amyyu11/autosterilizer/README.md

# autosterilizer
Automatic Ethanol Sterilizer Project repository. Done in collaboration with 5 other people from UCLA BMES.
