amyyu11/autosterilizer/visuals/PCB (FINAL) v3.png

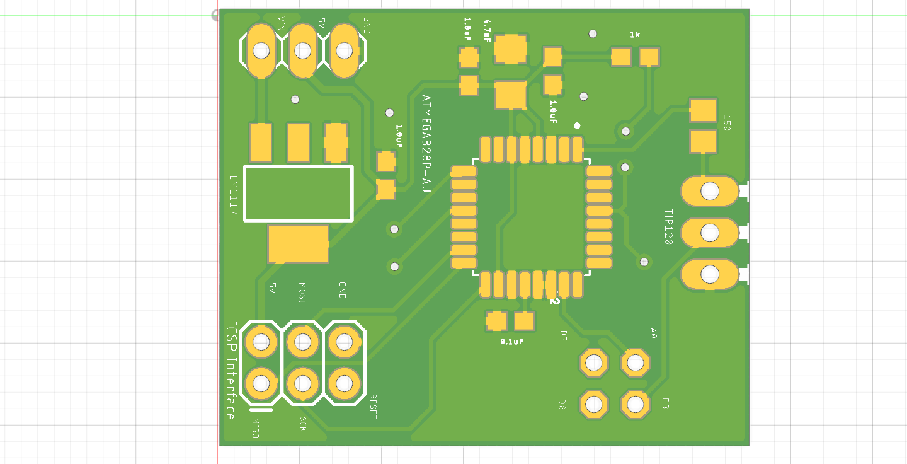
visuals/PCB (FINAL) v3.png
