amyyu11/autosterilizer/visuals/PCB cad object.png

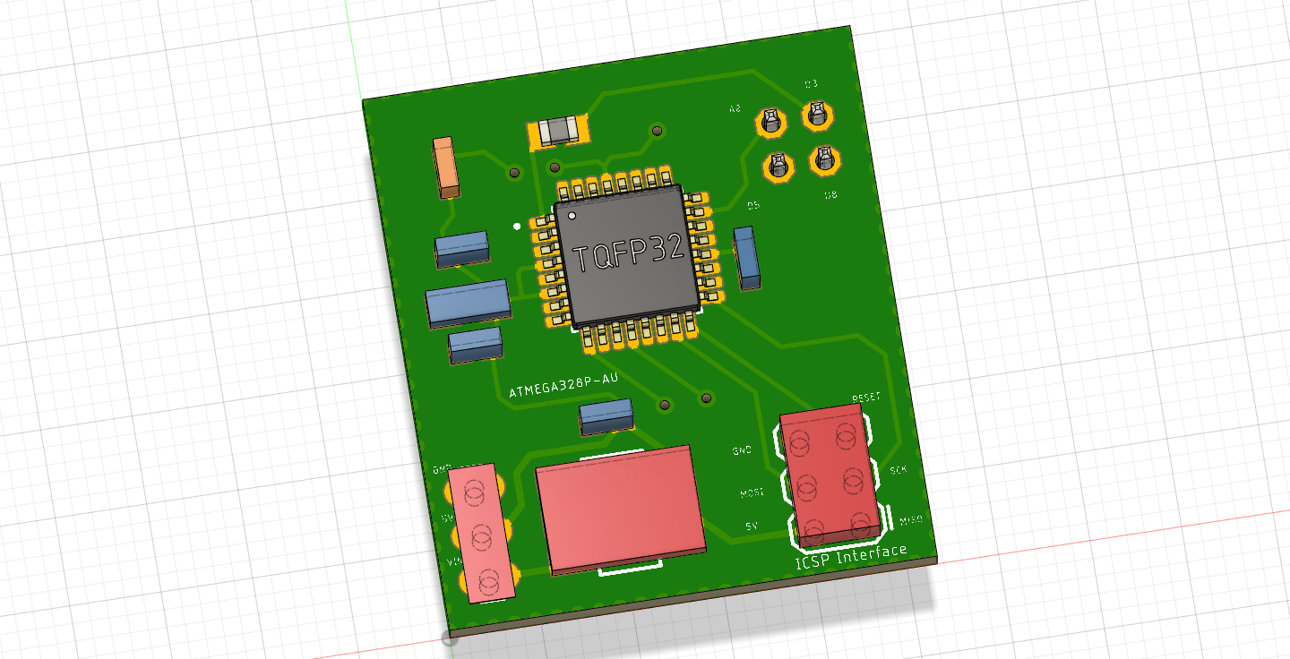
visuals/PCB cad object.png
