amyyu11/autosterilizer/visuals/Screen Shot 2020-05-18 at 12.31.32 PM.png

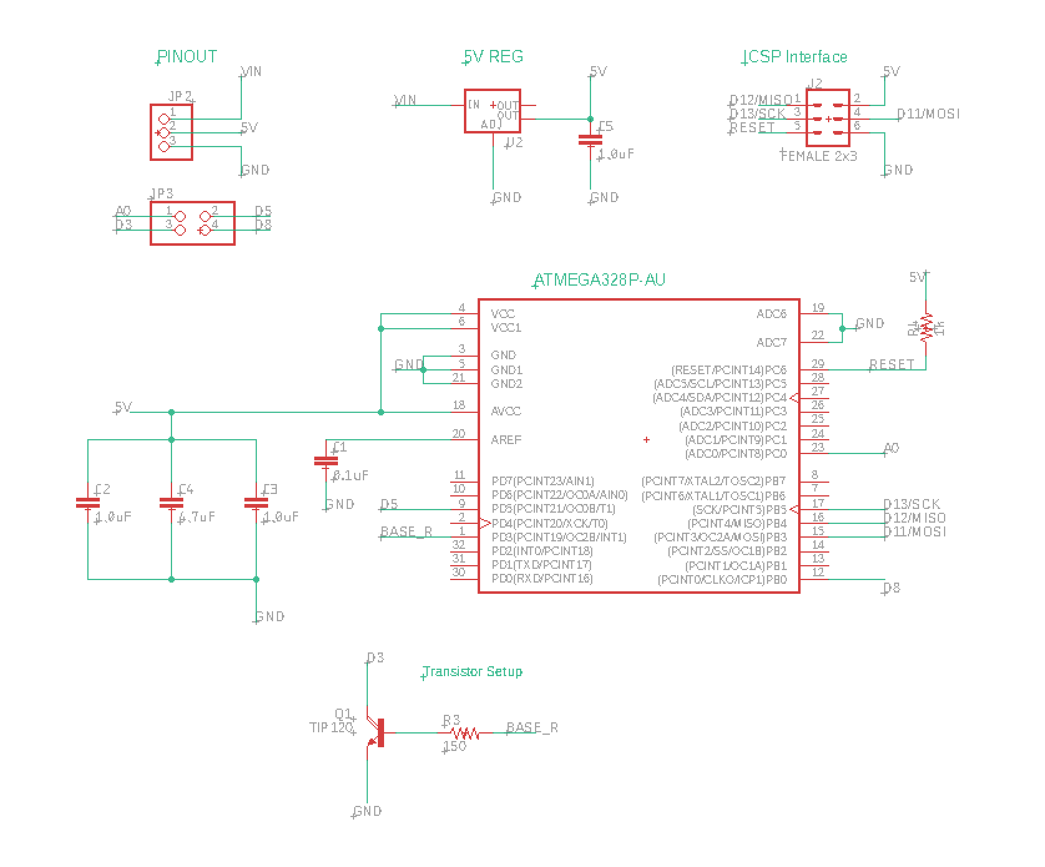
visuals/Screen Shot 2020-05-18 at 12.31.32 PM.png
