amyyu11/autosterilizer/other_materials/final components.xlsx

Component Name | Unit Price | Number | Total Price | Price Link | On Latex?
4 AA battery holder | 2.41 | 1 | 2.41 | https://www.digikey.com/product-detail/en/mpd-memory-protection-devices/BA4AAPC/BA4AAPC-ND/2439225
4 AA Batteries | 0.22 | 4 | 0.88 | https://www.digikey.com/product-detail/en/fdk-america-inc-a-member-of-fujitsu-group/LR6-C-2S/SY628-ND/5305214
PLA | 0.053/gram | 10 grams (?) | 0.53 | https://acrl.ala.org/techconnect/post/how-to-price-3d-printing-service-fees/
Potentiometer | 1 | 1 | 1 | https://www.adafruit.com/product/562
IR Sensor | 1 | 1 | 1 | https://www.amazon.com/OSOYOO-Infrared-Obstacle-Avoidance-Arduino/dp/B01I57HIJ0?ref_=fsclp_pl_dp_1
DS 3218mg Servo (20kg cm) | 13.92 | 1 | 18 | https://www.aliexpress.com/item/32891058701.html
ATMEGA328P-AU | 2.01 | 1 | 2.01 | https://www.digikey.com/product-detail/en/microchip-technology/ATMEGA328P-AU/ATMEGA328P-AU-ND/1832260 | x
LM1117 Voltage Regulator | 0.44 | 1 | 0.44 | https://www.digikey.com/product-detail/en/texas-instruments/LM1117IMPX-ADJ-NOPB/LM1117IMPX-ADJ-NOPBTR-ND/1870908 | x
TIP120 NPN Transistor | 0.93 | 1 | 0.93 | https://www.digikey.com/product-detail/en/on-semiconductor/TIP120/TIP120-ND/1052441 | x
0.1 uF (0603) | 0.01 | 1 | 0.01 | https://www.digikey.com/product-detail/en/murata-electronics/GRM033R61A104ME15D/490-5405-2-ND/2175191 | x
1 uF (0603) | 0.02 | 3 | 0.06 | https://www.digikey.com/product-detail/en/samsung-electro-mechanics/CL10A105KP8NNNC/1276-1182-2-ND/3886840 | x
4.7 uF (0603) | 0.03 | 1 | 0.03 | https://www.digikey.com/product-detail/en/yageo/CC0603MRX5R6BB475/311-1820-2-ND/5195227 | x
1K ohm (0603) | 0.01 | 1 | 0.01 | https://www.digikey.com/product-detail/en/panasonic-electronic-components/ERJ-3GEYJ102V/P1-0KGTR-ND/68472 | x
150 ohm (0805) | 0.02 | 1 | 0.02 | https://www.digikey.com/product-detail/en/rohm-semiconductor/KTR10EZPF1500/RHM150AHTR-ND/4051792 | x
2x1 Male Pin header | 0.05 | 3 | 0.15 | https://www.digikey.com/product-detail/en/harwin-inc/M20-9990246/952-2262-ND/3728226 | x
Breakable Female Header 40x1 | 1.5 | 0.275 | 0.4125 | https://www.sparkfun.com/products/115 | x
PCB Print Cost | 0.46 | 1 | 0.46 | https://onlinequote.7pcb.com/ | x
Elastic band | 0.3 | 1 | 0.3 | https://www.amazon.com/eBoot-Black-Elastic-Spool-Inch/dp/B01DXRG7JO
TOTAL |  |  | 28.6525
Cost without Headers |  |  | 28.09 | < oh, I've added some stuff to latex that's not here
NOTE: unit price estimate based off of assumption of 1000 pieces ordered (where applicable, and if link does not already specify number of pieces)
