amyyu11/autosterilizer/PCB/PCB.brd

## EAGLE design PCB/PCB.brd (2020-08-27)

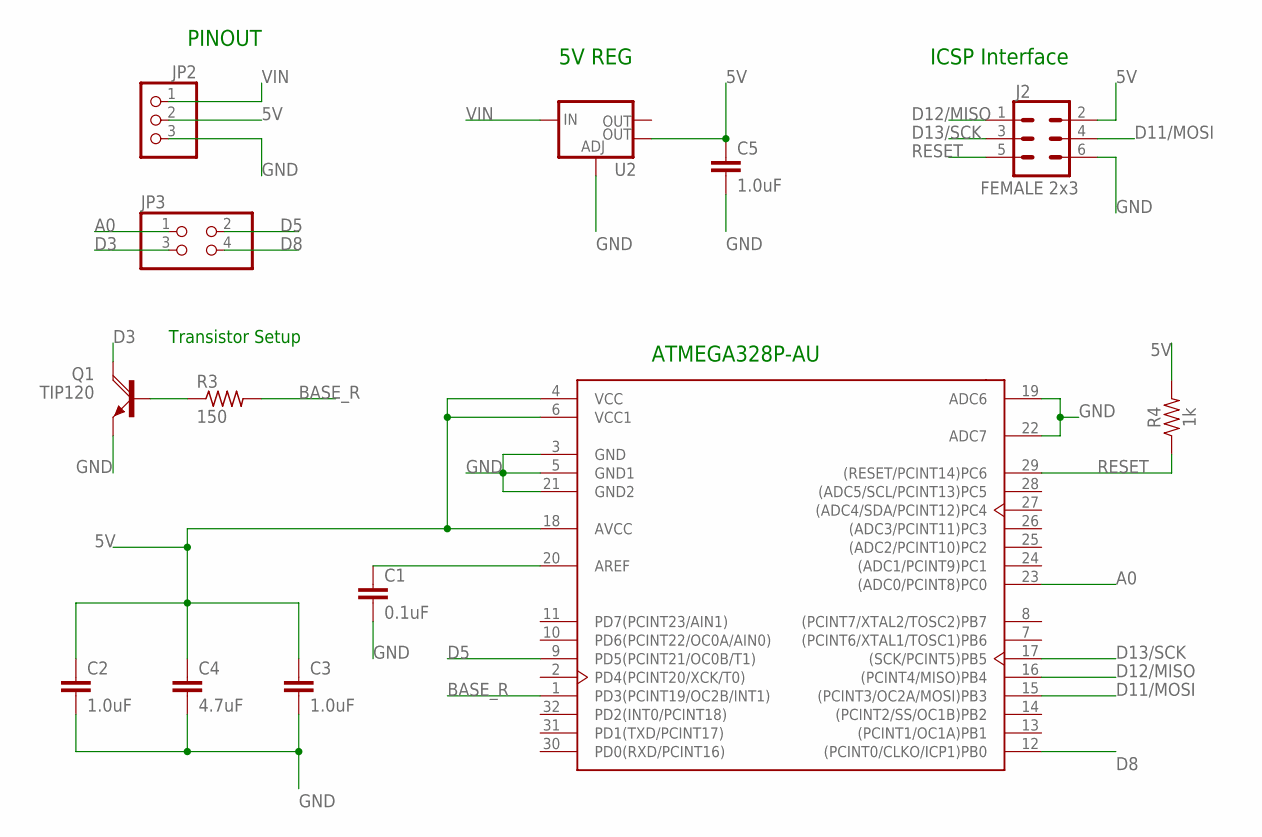
[picture p4: schematic PCB.sch]

Parts:
C1: 0.1uF; 0603
C2, C3, C5: 1.0uF; 0603
C4: 4.7uF; 1206
J2: FEMALE 2x3; 2X3
JP2: PINHEAD_PINHD-1X3; PINHEAD_1X03
JP3: PINHD-2X2; 2X02
Q1: TIP120; TO220AH
R3: 150; R0805
R4: 1k; 0603
U1: ATMEGA328P-AU; TQFP-32
U2: V_REG_LM1117SOT223; SOT223

Connections:
5V: C2.1, C3.1, C4.1, C5.1, J2.2, JP2.2, R4.2, U1.4 (VCC), U1.6 (VCC1), U1.18 (AVCC), U2.4 (OUT)
A0: JP3.1, U1.23 ((ADC0/PCINT8)PC0)
BASE_R: R3.2, U1.1 (PD3(PCINT19/OC2B/INT1))
D3: JP3.3, Q1.C
D5: JP3.2, U1.9 (PD5(PCINT21/OC0B/T1))
D8: JP3.4, U1.12 ((PCINT0/CLKO/ICP1)PB0)
D11/MOSI: J2.4, U1.15 ((PCINT3/OC2A/MOSI)PB3)
D12/MISO: J2.1, U1.16 ((PCINT4/MISO)PB4)
D13/SCK: J2.3, U1.17 ((SCK/PCINT5)PB5)
GND: C1.2, C2.2, C3.2, C4.2, C5.2, J2.6, JP2.3, Q1.E, U1.3 (GND), U1.5 (GND1), U1.19 (ADC6), U1.21 (GND2), U1.22 (ADC7), U2.1 (ADJ)
unnamed: Q1.B, R3.1
unnamed: C1.1, U1.20 (AREF)
RESET: J2.5, R4.1, U1.29 ((RESET/PCINT14)PC6)
VIN: JP2.1, U2.3 (IN)

Notes on the sheet:
ICSP Interface
5V REG
PINOUT
ATMEGA328P-AU
Transistor Setup

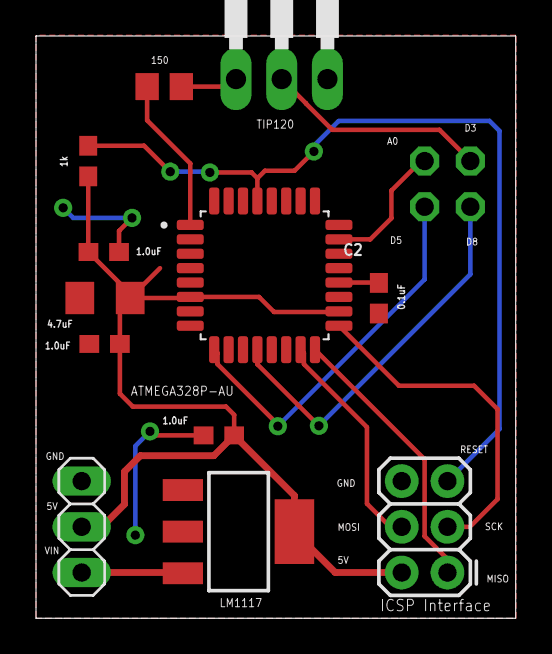
[picture p5: board PCB.brd from above]

Board: 2 copper layers, 26.6 x 32.3 mm, 13 parts (1 on the bottom side), 14 nets.
