amyyu11/autosterilizer/(commit log)

2020-08-27 Added project files.
    [PCB.brd, PCB.sch]
2020-08-27 Added more project files.
    [final components.xlsx]
2020-08-27 Reorganized directory structure
    [PCB.brd, PCB.sch, final components.xlsx]
2020-08-27 Cleaned up repo.
    [final components.xlsx]
